nykh/ee445m-robot-team13/Report/Rep6/CAN_Bandwidth_measurement.txt

100ms  O
10ms   O
5ms    O
4ms    X
3ms    X
2ms    X
1ms    X
