nykh/ee445m-robot-team13/Report/Rep6/report6.pdf

# EE445M Lab 6 Report

### Yen-Kai Huang, Siavash Zanganeh Kamali, Chen Cui, Miao Qi, Yan Zhang

### April 8, 2014

## 1 Objective

The goal of this lab is to prepare for the final Robot race. In this lab we will interface various components, including Ping)))) ultrasonic distance sensor, IR distance sensor, and DC motor. A layered communication system using CAN protocol will transmit the information between two microcontrollers. We will design and implement a software communication protocol to transmit the sensor data and other things.
In this lab we will also form a team of 4 or 5, which requires us also to apply communication skills to function as a team.

## 2 Hardware Design

Ping sensor is shown at Figure-1

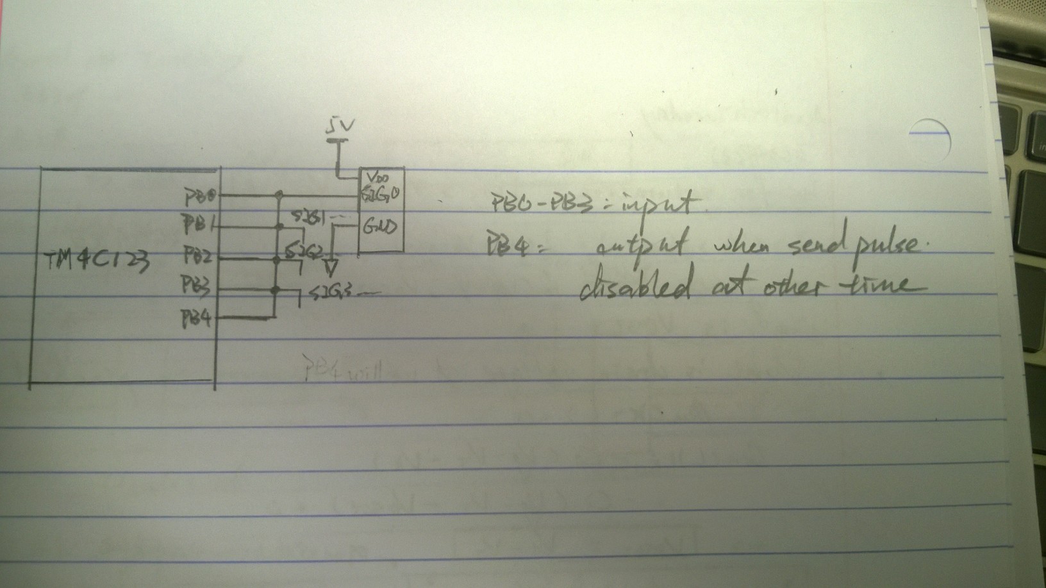
[picture p10: figure]

Figure 1

IR sensor is shown at Figure-2
The DC motor circuit is shown at Figure-3

1


Figure 2

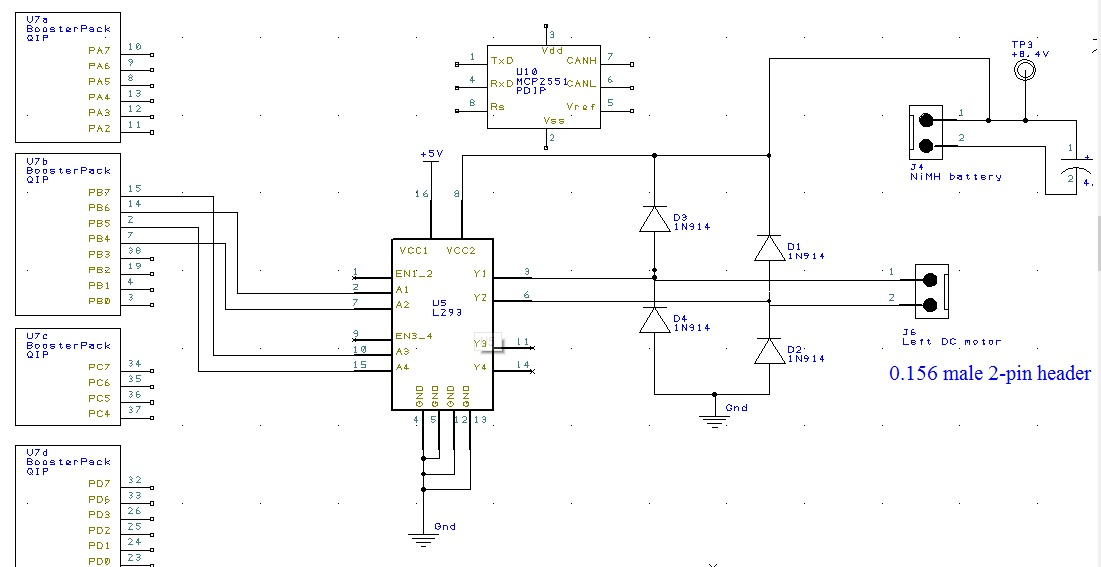
[picture p11: figure]

Figure 3

2

## 3 Software Design

(a) We made small changes to CAN0.c, replacing the spinlock mechanism with actual semaphore.
1 | // can0 .c
2 | // Runs on LM4F120 / TM4C123
3 | // Use CAN0 to communicate on CAN bus PE4 and PE5
4 | //

5
6 | // Jonathan Valvano
7 | // March 22 , 2014

8
9 | /* This example accompanies the books
10 | Embedded Systems : Real - Time Operating Systems for ARM Cortex -M
Microcontrollers , Volume 3 ,
11 ISBN : 978 -1466468863 , Jonathan Valvano , copyright (c) 2013

12
13 Embedded Systems : Real Time Interfacing to ARM Cortex M Microcontrollers , Volume 2
14 ISBN : 978 -1463590154 , Jonathan Valvano , copyright (c) 2013

15
16 | Copyright 2014 by Jonathan W. Valvano , valvano@mail . utexas .edu
17 | You may use , edit , run or distribute this file
18 | as long as the above copyright notice remains
19 | THIS SOFTWARE IS PROVIDED "AS IS ". | NO WARRANTIES , WHETHER EXPRESS ,
IMPLIED
20 | OR STATUTORY , INCLUDING , BUT NOT LIMITED TO , IMPLIED WARRANTIES OF
21 | MERCHANTABILITY AND FITNESS FOR A PARTICULAR PURPOSE APPLY TO THIS
SOFTWARE .
22 VALVANO SHALL NOT , IN ANY CIRCUMSTANCES , BE LIABLE FOR SPECIAL , INCIDENTAL ,
23 | OR CONSEQUENTIAL DAMAGES , FOR ANY REASON WHATSOEVER .
24 | For more information about my classes , my research , and my books , see
25 | http :// users .ece . utexas .edu /~ valvano /
26 | */
27 | // MCP2551 Pin1 TXD | ---- CAN0Tx PE5 (8) O TTL CAN module 0 transmit
28 | // MCP2551 Pin2 Vss | ---- ground
29 | // MCP2551 Pin3 VDD | ---- +5V with 0.1 uF cap to ground
30 | // MCP2551 Pin4 RXD | ---- CAN0Rx PE4 (8) I TTL CAN module 0 receive
31 | // MCP2551 Pin5 VREF ---- open (it will be 2.5 V)
32 | // MCP2551 Pin6 CANL ---- to other CANL on network
33 | // MCP2551 Pin7 CANH ---- to other CANH on network
34 | // MCP2551 Pin8 RS | ---- ground , Slope - Control Input ( maximum slew
rate )
35 // 120 ohm across CANH , CANL on both ends of network

36
37 | # include " hw_can .h"
38 | # include " hw_ints .h"
39 | # include " hw_memmap .h"
40 | # include " hw_types .h"
41 | # include "can.h"
42 | # include " debug .h"
43 | # include " interrupt .h"

44
45 | # include "os.h"
46 | # include " semaphore .h"

3

47
48 | # include " can0 .h"
49 | # include "inc/ tm4c123gh6pm .h"

50

51
52 | # define NULL 0
53 | // reverse these IDs on the other microcontroller

54
55 | // Mailbox linkage from background to foreground
56 | PackageID static RCVID ;
57 | unsigned char static RCVData [4];
58 | int static MailFlag ;

59
60 | // ************************************************************
61 | //
62 | // The CAN controller interrupt handler .
63 | //
64 | // ************************************************************
65 | void CAN0_Handler ( void ) { unsigned char data [4];
66 | unsigned long ulIntStatus , ulIDStatus ;
67 | int i ;
68 | tCANMsgObject xTempMsgObject ;
69 | xTempMsgObject . pucMsgData = data ;
70 | ulIntStatus = CANIntStatus ( CAN0_BASE , CAN_INT_STS_CAUSE ) ; // cause ?
71 | if( ulIntStatus & CAN_INT_INTID_STATUS ) { | // receive ?
72 | ulIDStatus = CANStatusGet ( CAN0_BASE , CAN_STS_NEWDAT ) ;
73 | for( i = 0; i < 32; i ++) { | // test every bit of the mask
74 | if( (0 x1 << i ) & ulIDStatus ) { | // if active , get data
75 | CANMessageGet ( CAN0_BASE , ( i +1) , & xTempMsgObject , true ) ;
76 | // if( xTempMsgObject . ulMsgID == RCV_ID ){
77 | RCVID = ( PackageID ) xTempMsgObject . ulMsgID ;
78 | RCVData [0] = data [0];
79 | RCVData [1] = data [1];
80 | RCVData [2] = data [2];
81 | RCVData [3] = data [3];
82 | // MailFlag = true ; | // new mail
83 | OS_bSignal (& Sema4CAN ) ;
84 | //}
85 | }
86 | }
87 | }
88 | CANIntClear ( CAN0_BASE , ulIntStatus ) ; | // acknowledge
89 | }

90
91 | // Set up a message object . | Can be a TX object or an RX object .
92 | void static CAN0_Setup_Message_Object ( unsigned long MessageID , \
93 | unsigned long MessageFlags , \
94 | unsigned long MessageLength , \
95 | unsigned char * MessageData , \
96 | unsigned long ObjectID , \
97 | tMsgObjType eMsgType ) {
98 | tCANMsgObject xTempObject ;
99 | xTempObject . ulMsgID = MessageID ; | // 11 or 29 bit ID
100 | xTempObject . ulMsgLen = MessageLength ;
101 | xTempObject . pucMsgData = MessageData ;
102 | xTempObject . ulFlags = MessageFlags ;

4

103 | CANMessageSet ( CAN0_BASE , ObjectID , & xTempObject , eMsgType ) ;
104 | }
105 | // Initialize CAN port
106 | void CAN0_Open ( void ) { unsigned long volatile delay ;

107
108 | MailFlag = false ;
109 | OS_InitSemaphore (& Sema4CAN , 0) ;

110
111 | SYSCTL_RCGCCAN_R |= 0 x00000001 ; | // CAN0 enable bit 0
112 | SYSCTL_RCGCGPIO_R |= 0 x00000010 ; | // RCGC2 portE bit 4
113 | for( delay =0; delay <100; delay ++) {};
114 | GPIO_PORTE_AFSEL_R |= 0 x30 ; // PORTE AFSEL bits 5 ,4
115 | // PORTE PCTL 88 into fields for pins 5 ,4
116 | GPIO_PORTE_PCTL_R = ( GPIO_PORTE_PCTL_R &0 xFF00FFFF ) |0 x00880000 ;
117 | GPIO_PORTE_DEN_R |= 0 x30 ;
118 | GPIO_PORTE_DIR_R |= 0 x20 ;

119
120 | CANInit ( CAN0_BASE ) ;
121 | CANBitRateSet ( CAN0_BASE , 80000000 , CAN_BITRATE ) ;
122 | CANEnable ( CAN0_BASE ) ;
123 | // make sure to enable STATUS interrupts
124 | CANIntEnable ( CAN0_BASE , CAN_INT_MASTER | CAN_INT_ERROR |
CAN_INT_STATUS ) ;
125 | // Set up filter to receive these IDs
126 | // in this case there is just one type , but you could accept multiple
ID types
127 // CAN0_Setup_Message_Object (RCV_ID , MSG_OBJ_RX_INT_ENABLE , 4 , NULL , RCV_ID , MSG_OBJ_TYPE_RX );
128 CAN0_Setup_Message_Object (( unsigned long ) ( IRSensor0 ) , MSG_OBJ_RX_INT_ENABLE , 4 , NULL , ( unsigned long ) ( IRSensor0 ) , MSG_OBJ_TYPE_RX ) ;
129 CAN0_Setup_Message_Object (( unsigned long ) ( UltraSonic ) , MSG_OBJ_RX_INT_ENABLE , 4 , NULL , ( unsigned long ) ( UltraSonic ) , MSG_OBJ_TYPE_RX ) ;
130 | NVIC_EN1_R = (1 << ( INT_CAN0 - 48) ) ; // IntEnable ( INT_CAN0 );
131 | return ;
132 | }

133
134 | // send 4 bytes of data to other microcontroller
135 | void CAN0_SendData ( PackageID sendID , unsigned char data [4]) {
136 | // in this case there is just one type , but you could accept multiple
ID types
137 CAN0_Setup_Message_Object (( unsigned long ) sendID , NULL , 4 , data , ( unsigned long ) sendID , MSG_OBJ_TYPE_TX ) ;

138 }

139
140 | // Returns true if receive data is available
141 | // | false if no receive data ready
142 | int CAN0_CheckMail ( void ) {
143 | return MailFlag ;
144 | }
145 | // if receive data is ready , gets the data and returns true
146 | // if no receive data is ready , returns false
147 | /* **** Not implemented
148 | int CAN0_GetMailNonBlock ( unsigned char data [4]) {
149 | if( MailFlag ){

5

150 | data [0] = RCVData [0];
151 | data [1] = RCVData [1];
152 | data [2] = RCVData [2];
153 | data [3] = RCVData [3];
154 | MailFlag = false ;
155 | return true ;
156 | }
157 | return false ;
158 | }
159 | */

160
161 | // if receive data is ready , gets the data
162 | // if no receive data is ready , it waits until it is ready
163 | void CAN0_GetMail ( PackageID * receiveID , unsigned char data [4]) {
164 | OS_bWait (& Sema4CAN ) ;
165 | * receiveID = RCVID ;
166 | data [0] = RCVData [0];
167 | data [1] = RCVData [1];
168 | data [2] = RCVData [2];
169 | data [3] = RCVData [3];
170 | }

code/can0.c

We also modified the FIFO macro to internally include semaphores.

1 | // FIFO .h
2 | // Runs on any LM3Sxxx
3 | // Provide functions that initialize a FIFO , put data in , get data out ,
4 | // and return the current size . | The file includes a transmit FIFO
5 | // using index implementation and a receive FIFO using pointer
6 | // implementation . | Other index or pointer implementation FIFOs can be
7 | // created using the macros supplied at the end of the file .
8 | // Daniel Valvano
9 | // June 16 , 2011

10
11 | // April 2 , 2014
12 | // Modified
13 | // - Added semaphore
14 | // Nick Huang

15
16 | /* This example accompanies the book
17 | " Embedded Systems : Real Time Interfacing to the Arm Cortex M3" ,
18 | ISBN : 978 -1463590154 , Jonathan Valvano , copyright (c) 2011
19 | Programs 3.7 , 3.8. , 3.9 and 3.10 in Section 3.7

20
21 | Copyright 2011 by Jonathan W. Valvano , valvano@mail . utexas .edu
22 | You may use , edit , run or distribute this file
23 | as long as the above copyright notice remains
24 | THIS SOFTWARE IS PROVIDED "AS IS ". | NO WARRANTIES , WHETHER EXPRESS ,
IMPLIED
25 | OR STATUTORY , INCLUDING , BUT NOT LIMITED TO , IMPLIED WARRANTIES OF
26 | MERCHANTABILITY AND FITNESS FOR A PARTICULAR PURPOSE APPLY TO THIS
SOFTWARE .
27 VALVANO SHALL NOT , IN ANY CIRCUMSTANCES , BE LIABLE FOR SPECIAL , INCIDENTAL ,
28 OR CONSEQUENTIAL DAMAGES , FOR ANY REASON WHATSOEVER .

6

29 | For more information about my classes , my research , and my books , see
30 | http :// users .ece . utexas .edu /~ valvano /
31 | */

32
33 | // macro to create an index FIFO
34 | # define AddIndexSema4Fifo (NAME ,SIZE ,TYPE , SUCCESS , FAIL ) \
35 | Sema4Type Sema4 ## NAME ; | \
36 | unsigned long volatile NAME ## PutI ; | \
37 | unsigned long volatile NAME ## GetI ; | \
38 | TYPE static NAME ## Fifo [ SIZE ]; | \
39 | void NAME ## Fifo_Init ( void ){ long sr; | \
40 | sr = StartCritical () ; | \
41 | NAME ## PutI = NAME ## GetI = 0; | \
42 | EndCritical ( sr ) ; | \
43 | OS_InitSemaphore (& Sema4 ## NAME , 0); | \
44 | } | \
45 | int NAME ## Fifo_Put ( TYPE data ){ | \
46 | if (( NAME ## PutI - NAME ## GetI ) & ~( SIZE -1) ){ | \
47 | return ( FAIL ) ; | \
48 | } | \
49 | NAME ## Fifo [ NAME ## PutI &( SIZE -1) ] = data ; \
50 | NAME ## PutI ## ++; | \
51 | OS_Signal (& Sema4 ## NAME ); \
52 | return ( SUCCESS ) ; | \
53 | } | \
54 | int NAME ## Fifo_Get ( TYPE * datapt ){ | \
55 | OS_Wait (& Sema4 ## NAME ); \
56 | if( NAME ## PutI == NAME ## GetI ){ \
57 | return ( FAIL ) ; | \
58 | } | \
59 | * datapt = NAME ## Fifo [ NAME ## GetI &( SIZE -1) ]; | \
60 | NAME ## GetI ## ++; | \
61 | return ( SUCCESS ) ; | \
62 | } | \
63 | unsigned short NAME ## Fifo_Size ( void ){ | \
64 | return (( unsigned short ) ( NAME ## PutI - NAME ## GetI )); | \
65 | }

66
67 | # define AddCallBackFunction ( NAME ) \
68 | long NAME ## DataLost ; | \
69 | void NAME ## CallBack ( unsigned short ADCvalue ) { \
70 | if (! NAME ## Fifo_Put ( ADCvalue )){ | \
71 | NAME ## DataLost ++; | \
72 | } | \
73 | }

code/FIFO sema4.h

(b) IR sensor code is basically the same as Lab. 4, except that I decoupled the Filter() functions from the filter buffer. The call-back functions in ADC routine is now responsible for acquiring and storing the data.

1 // IR_sensor .h

2
3 | # ifndef __IR_SENSOR_H__
4 | # define __IR_SENSOR_H__

7

5
6 # define LAB_DEMO 6

7
8 | void IR_Init ( void ) ;
9 | void IR_getValues ( unsigned short * buffer ) ;

10
11 | # endif // __IR_SENSOR_H__
| | | code/ir sensor.h
1 | // IR_sensor .c

2
3 # include " ir_sensor .h"

4
5 | # include "OS.h"
6 | # include " FIFO_sema4 .h"
7 | # include "adc.h"

8
9 # define SAMPLING_RATE 2000

10
11 | /* ********************* Data Structure ****************** */
12 | # define FIFOSIZE | 64 | // size of the FIFOs ( must be power of 2)
13 | # define FIFOSUCCESS 1 | // return value on success
14 | # define FIFOFAIL | 0 | // return value on failure
15 | | | // create index implementation FIFO (see
| FIFO .h)
16 | long StartCritical ( void ) ; | // previous I bit , disable interrupts
17 | void EndCritical ( long sr ) ; | // restore I bit to previous value

18
19 | AddIndexSema4Fifo ( IR1 , FIFOSIZE , unsigned short , FIFOSUCCESS , FIFOFAIL )
20 | AddCallBackFunction ( IR1 )

21
22 | #if LAB_DEMO == 7
23 | AddIndexSema4Fifo ( IR2 , FIFOSIZE , unsigned short , FIFOSUCCESS , FIFOFAIL )
24 | AddCallBackFunction ( IR2 )
25 | AddIndexSema4Fifo ( IR3 , FIFOSIZE , unsigned short , FIFOSUCCESS , FIFOFAIL )
26 | AddCallBackFunction ( IR3 )
27 | AddIndexSema4Fifo ( IR4 , FIFOSIZE , unsigned short , FIFOSUCCESS , FIFOFAIL )
28 | AddCallBackFunction ( IR4 )
29 | # endif

30
31 | /* ********************** Filter *************************** */
32 | # define FILTER_LENGTH 51
33 | const long ScaleFactor = 16384;
34 | const long H [51]={ -11 ,10 ,9 , -5 ,1 ,0 , -19 ,6 ,48 , -12 , -92 ,
35 | 17 ,155 , -20 , -243 ,22 ,370 , -24 , -559 ,24 ,881 , -24 , -1584 ,24 ,4932 ,
36 | 8578 ,4932 ,24 , -1584 , -24 ,881 ,24 , -559 , -24 ,370 ,22 , -243 , -20 ,155 ,
37 | 17 , -92 , -12 ,48 ,6 , -19 ,0 ,1 , -5 ,9 ,10 , -11};

38
39 | typedef struct {
40 | // this MACQ needs twice the size of FILTER_LENGTH
41 | long x [2* FILTER_LENGTH ];
42 | unsigned char index ;
43 | } FilterType ;

44
45 | static unsigned short IRsensor1 ;
| | | 8

46
47 static FilterType filter1 = {{0} , FILTER_LENGTH -1};

48
49 | // Filter
50 | // Digital FIR filter , assuming fs =1 Hz
51 | // Coefficients generated with FIRdesign64 .xls
52 | // y[i]= (h [0]* x[i]+h [1]* x[i -1]+ | +h [63]* x[i -63]) /256;
53 | static unsigned short Filter ( FilterType *f , unsigned short data ) {
54 | long y = 0;
55 | unsigned char i ;

56
57 | if (++ f - > index == 2* FILTER_LENGTH ) f - > index = FILTER_LENGTH ;
58 | f - > x [f - > index ] = f - > x [f - > index - FILTER_LENGTH ] = data ;

59
60 | // Assuming there is no overflow
61 | for( i = 0; i < FILTER_LENGTH ; ++ i ) {
62 | y += H [ i ]* f - > x [f - > index - i ];
63 | }
64 | y /= ScaleFactor ;

65
66 | return y ;
67 | }

68
69 /* *************************************************** */

70
71 | // Consumer
72 | // Foreground thread that takes in data from FIFO , apply filter , and
record data
73 // If trigger Capture is set , it will perform a 64 - point FFT on the recorded data
74 | // and store result in fft_output []
75 | // Block when the FIFO is empty
76 | # define NOW_USING | 1
77 | # define STOP_USING | 0
78 | # define NOT_USING | -1
79 | char Filter_Use = NOT_USING ;

80
81 | static void Consumer ( void ) {
82 | ADC_Collect (0 , SAMPLING_RATE , IR1CallBack , 64) ;

83
84 | while (1) {
85 | // Get data , will block if FIFO is empty
86 | unsigned short data ;
87 | IR1Fifo_Get (& data ) ;

88
89 | // Choosing whether to apply the filter
90 | IRsensor1 = Filter (& filter1 , data ) ;
91 | }
92 | }

93
94 | void IR_Init ( void ) {
95 | OS_InitSemaphore (& Sema4DataAvailable , 0) ;

96
97 IR1Fifo_Init () ;

98
99 OS_AddThread (& Consumer , 256 , 3) ;

9

100 }

101
102 | void IR_getValues ( unsigned short * buffer ) {
103 | buffer [0] = IRsensor1 ;
104 | #if LAB_DEMO == 7
105 | buffer [1] = IRsensor2 ;
106 | buffer [2] = IRsensor3 ;
107 | buffer [3] = IRsensor4 ;
108 | # endif
109 | }
| | code/ir sensor.c

For the Ping))) interfacing, we used one pin to output the 5 µs pulse, and one pin for each sensor set to trigger an interrupt at both edges. The handler will calculate the difference of time between the two edges and thus determine the distance measurement.

1 | // Ping .h
2 | // Runs on LM4C123
3 | // Initialize Ping interface , then generate 5us pulse about 10 times
| per second
4 | // capture input pulse and record pulse width
5 | // Miao Qi
6 | // October 27 , 2012

7
8 | // initialize PB4 -0
9 | // PB4 set as output to send 5us pulse to all four Ping ))) sensors at
| same time
10 | // PB3 -0 set as input to capture input from sensors
11 | void Ping_Init ( void ) ;

12
13 | void Ping_getData ( unsigned long * data ) ;
| | code/ping.h
1 | // Ping .c
2 | // Runs on LM4C123
3 | // Initialize Ping interface , then generate 5us pulse about 10 times
| per second
4 | // capture input pulse and record pulse width
5 | // Miao Qi
6 | // October 27 , 2012

7
8 | # include "inc/ tm4c123gh6pm .h"
9 | # include "OS.h"

10
11 | # define PB4 | (*(( volatile unsigned long *)0 x40005040 ))
12 | # define PB3_0 | (*(( volatile unsigned long *)0 x4000503C ))
13 | # define Temperature | 20
14 | # define NVIC_EN0_INT1 | 2

15
16 # define TIME_1MS 80000

17
18 | unsigned long Ping_Lasttime [4];
19 | unsigned long Ping_Finishtime [4];
20 | unsigned char Ping_Update ;
21 | unsigned long Ping_Distance_Result [4];

10

22 | unsigned long Ping_Distance_Filter [4][4];
23 | // unsigned long Ping_Distance_cal [10];
24 | unsigned long Ping_Index [4];
25 | unsigned long Ping_laststatus ;

26
27 void Ping_pulse ( void ) ;

28
29 | // initialize PB4 -0
30 | // PB4 set as output to send 5us pulse to all four Ping ))) sensors at
same time
31 | // PB3 -0 set as input to capture input from sensors
32 | void Ping_Init ( void ) {
33 | // (a) activate clock for port F
34 | SYSCTL_RCGC2_R |= SYSCTL_RCGC2_GPIOB ;
35 | Ping_laststatus = 0; | // (b) initialize status
36 | GPIO_PORTB_DIR_R &= ~0 x0F ; | // (c) make PB3 -0 in
37 | GPIO_PORTB_DIR_R |= | 0 x10 ; | // (c) make PB4 out
38 | GPIO_PORTB_AFSEL_R &= ~0 x1F ; | // | disable alt funct on PB4 -0
39 | GPIO_PORTB_DEN_R |= 0 x1F ; | // | enable digital I/O on PB4 -0
40 | GPIO_PORTB_PCTL_R &= ~0 x000FFFFF ; // configure PB4 -0 as GPIO
41 | GPIO_PORTB_AMSEL_R = 0; | // | disable analog functionality on
PB
42 | GPIO_PORTB_PDR_R |= 0 x1F ; | // | enable pull - down on PF4 -0
43 | GPIO_PORTB_IS_R &= ~0 x0F ; | // (d) PB3 -0 is edge - sensitive
44 | GPIO_PORTB_IBE_R |= 0 x0F ; | // | PB3 -0 is both edges
45 | GPIO_PORTB_ICR_R = | 0 x0F ; | // (e) clear flag3 -0
46 | GPIO_PORTB_IM_R |= 0 x0F ; | // (f) arm interrupt on PB3 -0
47 | NVIC_PRI0_R = ( NVIC_PRI0_R &0 xFFFF00FF ) |0 x00004000 ; // (g) priority 2
48 | NVIC_EN0_R |= NVIC_EN0_INT1 ; | // (h) enable interrupt 1 in NVIC
49 | OS_AddPeriodicThread (& Ping_pulse , 100* TIME_1MS , 3) ;
50 | }

51
52 | extern unsigned char SendPulse ;
53 | extern unsigned long PulseCount ;
54 | // Send pulse to four Ping ))) sensors
55 | // happens periodically by using timer
56 | // foreground thread
57 | // Fs: about 10 Hz
58 | // no input and no output

59
60 | void Ping_pulse ( void ) {
61 | unsigned char delay_count ;
62 | GPIO_PORTB_DEN_R |= 0 x10 ;
63 | GPIO_PORTB_DEN_R &= ~0 x0F ;
64 | PB4 = 0 x10 ;
65 | // blind - wait
66 | for( delay_count =0; delay_count <60; ) { delay_count ++;}
67 | PB4 = 0 x00 ;
68 | GPIO_PORTB_DEN_R &= ~0 x10 ;
69 | GPIO_PORTB_DEN_R |= | 0 x0F ;
70 | }

71
72 | unsigned long median ( unsigned long * data_record ) {
73 | unsigned long buffer [4];
74 | // compare the oldest two data
75 | if ((* data_record ) <*( data_record +1) )

11

76 | { buffer [0]=* data_record ; buffer [1]=*( data_record +1) ;}
77 | else
78 | { buffer [1]=* data_record ; buffer [0]=*( data_record +1) ;}
79 | // compare the third data
80 | if( buffer [0] <*( data_record +2) ) {
81 | if( buffer [1] <*( data_record +2) ) { buffer [2]=*( data_record +2) ;}
82 | else { buffer [2]= buffer [1]; buffer [1]=*( data_record +2) ;}
83 | }
84 | else { buffer [2]= buffer [1]; buffer [1]= buffer [0]; buffer [0]=*( data_record
+2) ;}
85 | // compare the forth data
86 | // ingore the forth data when it is the laragest
87 | if( buffer [2] >*( data_record +3) ) {
88 | | // ingore the forth data when it is the smallest
89 | | if( buffer [0] >*( data_record +3) ) { buffer [2]= buffer [1]; buffer [1]= buffer
[0];}}
90 | | else { buffer [2]=*( data_record +3) ;}
91 | return ( buffer [1]+ buffer [2]) > >1;
92 | }

93

94

95
96 | //d=c* tIN /2
97 | //d = c * tIN * 12.5 ns /2 * (um/us)
98 | //d = c * tIN * (1 us /40) /(2*2) * (um/us)
99 | //d = c * tIN / (40*2*2) * um
100 | // ignore underflow
101 | // +0.5: round
102 | // return distance = (( tin /40) *(331+0.6* Temperature +0.5) )/4;
103 | // compute and update distance array for four sensors
104 | // called when PORTB3 -0 capture a value change
105 | // output resolution um
106 | void Distance ( void ) {
107 | unsigned char bits_I = 0;
108 | unsigned long tin ;
109 | for ( bits_I =0; bits_I <4; bits_I ++)
110 | if( Ping_Update &(1 < < bits_I ) ) {
111 | | tin = OS_TimeDifference ( Ping_Finishtime [ bits_I ] , Ping_Lasttime [
bits_I ]) ;
112 | | tin = (( tin /40) *(331+0.6* Temperature +0.5) ) /4;
113 | | Ping_Distance_Filter [ bits_I ][ Ping_Index [ bits_I ]&0 x3 ] = tin ;
114 | | Ping_Index [ bits_I ]++;
115 | | Ping_Distance_Result [ bits_I ] = median (& Ping_Distance_Filter [ bits_I
][0]) ;
116 | // | Ping_Distance_Result [ bits_I ] = tin //80000;
117 | | Ping_Update &= ~(1 < < bits_I ) ;
118 | }
119 | }

120

121
122 | // put inside PORTB_handler
123 | // input system time , resolution : 12.5 ns
124 | // no output
125 | void GPIOPortB_Handler ( void ) {
126 | // void Ping_measure ( void ){
127 | unsigned char bits_I = 0;
| | 12

128 | unsigned long Ping_status ;
129 | Ping_status = PB3_0 ;
130 | // check rising edge and record time
131 | for ( bits_I =0; bits_I <4; bits_I ++) {
132 | Ping_Lasttime [ bits_I ] = (( Ping_status &(1 < < bits_I ) ) && !(
| Ping_laststatus &(1 < < bits_I ) ) ) ? OS_Time () : Ping_Lasttime [ bits_I ];
133 | GPIO_PORTB_ICR_R = 1 < < bits_I ;
134 | }
135 | // check falling edge and compute distance
136 | for ( bits_I =0; bits_I <4; bits_I ++) {
137 | Ping_Finishtime [ bits_I ] = (!( Ping_status &(1 < < bits_I ) ) && (
| Ping_laststatus &(1 < < bits_I ) ) ) ? OS_Time () : Ping_Finishtime [ bits_I ];
138 | GPIO_PORTB_ICR_R = 1 < < bits_I ;
139 | Ping_Update |= 1 < < bits_I ;
140 | }
141 | Ping_laststatus = Ping_status ;
142 | }

143
144 | void Ping_getData ( unsigned long * data ) {
145 | int i ;
146 | Distance () ;
147 | for ( i =0; i <4; i ++) {
148 | data [ i ] = Ping_Distance_Result [ i ];
149 | }
150 | }
| code/ping.c
(c) The code that sets up the distributed data acquisition system comes in two sides. On the transmitter side, the main initializes the sensors and network, and sends data periodically at about 10 Hz.
1 | void NetworkSend ( void ) {
2 | unsigned short IRvalues [4];
3 | unsigned long sonarValues [4];
4 | unsigned char CanData [4];

5
6 | IR_getValues ( IRvalues ) ;
7 | (( unsigned short *) CanData ) [0] = IRvalues [0];
8 | CAN0_SendData ( IRSensor0 , CanData ) ;

9
10 | Ping_getData ( sonarValues ) ;
11 | (( unsigned long *) CanData ) [0] = sonarValues [0];
12 | CAN0_SendData ( UltraSonic , CanData ) ;
13 | }

14
15 | int main ( void ) {
16 | PLL_Init () ;
17 | OS_Init () ;

18
19 | // Initialize sensors
20 | IR_Init () ;
21 | Ping_Init () ;

22
23 | // Initialize network
24 | CAN0_Open () ;

25

| 13

NumCreated += OS_AddPeriodicThread (& NetworkSend , 100* TIME_1MS , 3) ;

OS_Launch ( TIMESLICE ) ;

}

code/main TX.c

On the receiver side, the main initializes the display and network, then add a thread that waits for the packet from the network. Once it receives a packet, it checks the packet ID to determine the type of data and then publish it to the display.

void NetworkReceive ( void ) {
PackageID receiveID ;
unsigned char canData [4];

// Initialize network
CAN0_Open () ;

while (1) {
CAN0_GetMail (& receiveID , canData ) ;
switch ( receiveID ) {
case IRSensor0 :
ST7735_Message (0 ,0 ,"IR0 : ", (( unsigned short *) canData ) [0]) ; dataReceived ++;
break ;
case UltraSonic :
ST7735_Message (0 ,1 ," ULS0 : ", (( unsigned long *) canData ) [0]) ; break ;
default :
break ;

}

}

}

int main ( void ) {
PLL_Init () ;
OS_Init () ;

// Initialize Display
ST7735_InitR ( INITR_REDTAB ) ; ST7735_SetRotation (1) ;
ST7735_FillScreen (0) ;

NumCreated += OS_AddThread (& NetworkReceive ,128 ,1) ;

OS_Launch ( TIMESLICE ) ;

}

code/main RX.c

This is a very simplistic example, however, it contains the full range of function for a distributed Data Acquisition System.

## 4 Measurement

(a) Ping))) Calibration Ping measurements in Table-1

14

Ping measurements
Truth dT(cm) | measured dM(cm) | standard deviation | span
10 20 30 50 80 | 10.1538 20.7653 31.4354 52.7532 83.1323 | 10.2742 20.9498 31.2317 52.8654 82.1398 | 10.129 20.4286 31.2342 52.2543 83.2538 | 10.2398 20.5348 31.5463 52.7397 84.0132 | 9.9102 20.8695 31.8467 52.9485 83.8764 | 10.1231 21.0135 31.6756 53.0123 83.1233 | 10.2314 20.8493 31.3765 52.9475 82.4956 | 9.9324 20.9756 31.0475 53.2397 83.2835 | 0.136715993 0.212323325 0.260240679 0.286319955 0.626714781 | 0.364 0.5849 0.7992 0.9854 1.8734

Table 1: Ping measurements

IR sensor measurements
Truth dT(c0) | ADC average | ADC Std. Dev. | ADC span | Voltage average(V) | Voltage Std. Dev.(V) | Voltage span (V)
10 15 20 25 30 35 40 45 50 | 2822 1979 1570 1282 1114 941 848 748 675 | 5 4 5 6 5 2 7 6 5 | 19 15 19 25 27 8 23 24 18 | 2.067 1.450 1.150 0.939 0.816 0.689 0.621 0.548 0.494 | 0.004 0.003 0.003 0.005 0.004 0.001 0.005 0.004 0.003 | 0.014 0.011 0.014 0.018 0.020 0.006 0.017 0.018 0.013

Table 2: IR measurements

(b) IR sensor Calibration IR sensor measurements in Table-2
(c) IR sensor noise spectrum We held a piece of paper constant from the IR sensor and recorded this noise spectrum. Because the measured object is nearly static, everything except the DC component should be considered noise. The noise therefore includes a noise floor that spans all frequencies. The major source of the noise is the thermal noise that includes all frequency and with amplitude of 1
f

. The
other source of noise is electrostatics property of the sensor itself, which shows a visible small squarewave in the time domain. This squarewave translates to a noise of all frequency in the frequency domain.

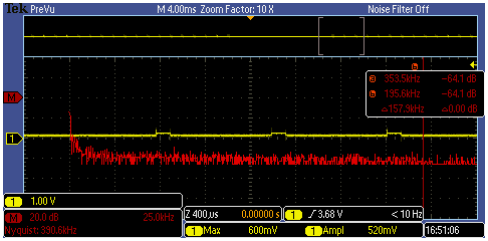
[picture p12: figure]

Figure 4: Frequency spectrum of noise

(d) Motor DC Motor measurements in Table-3
(e) CAN scope picture Below is a CAN packet measured at the CANH bus (yellow) and the microcontroller output (blue). It can be observed that the CANH signal is a inverted version of the microcontroller output, however the microcontroller output is changing between 0 and 3.3 V , and the CANH signal is changing between about 2.5 and 3.8 V . Also, the length of a typical packet is 161.7 µs
(f) CAN Network bandwidth We set the CAN network bit rate at 1M bit and decrease the sampling period of IR sensor. The result is shown in Table-4.
Therefore we deduct the maximum sampling rate the system can handle is 1
5 ms×4 bytes = 800 bytes/sec. Considering the packet length measured in Figure-5, CAN network itself should not be the limiting fac-

15

DC Motor measurements
Condition | Voltage across motor | Current
no-load with rubber wheel wheel & on carpet | 4.41v 4.42v 4.42v | 32mA 34mA 100mA

Table 3: DC motor measurements

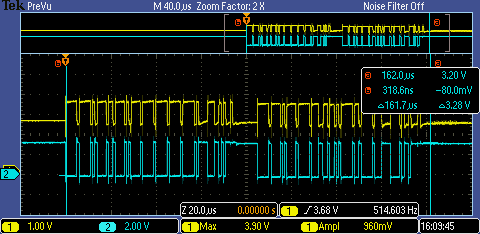
[picture p13: figure]

Figure 5: Scope trace of a typical CAN packet

CAN Bandwidth
Sampling Rate | Data Lost
100 ms 10 ms 5 ms 4 ms 3 ms 2 ms 1 ms | No No No Yes Yes Yes Yes

Table 4: Bandwith measurement

16 tor. The limiting factor is probably the execution speed of the data acquisition thread on the receiver side, which needs to run a 51-point filter code for each IR sensor data.

## 5 Analysis

(1) What is one advantage of the Ping))) sensor over the GP2Y0A21YK sensor? Ping))) outputs a PWM signal which duty cycles changes linearly with respect to the distance, so it’s easier to convert the raw data to distance.
(2) What is one advantage of the GP2Y0A21YK sensor over the Ping))) sensor GP2Y0A21YK measures the distance by an analog voltage. It is easier to convert voltage to digital data using ADC compared to measure time in Ping.
(3) Describe the noise of the GP2Y0A21YK when measured with a spectrum analyzer. The noise of the sensor is periodic square waves. An square wave contains all different frequencies, with Maximum amplitude at the frequency of the square wave. You can see that the spectrum detects many different frequencies.
(4) Why did you choose the digital filters for your sensors?
What is the time constant for this filter? I.e., if there is a step change in input, how long until your output changes to at least 1/e of the final value?
Since the transition bandwidth of the analog filter is too large for a 2-pole low-pass filter, therefore we use the digital filter to filter out the noise.
An analog filter with higher poles is more expensive.
Since we’re using a 51 point FIR filter, and 1/e = 0.36, we need to sample about 17 points to get enough data to represent 0.36 of the input.
Therefore, time constant = 17
fc

= 8.5 ms

(5) Present an alternative design for your H-bridge and describe how your H-bridge is better or worse?
Alternate design is shown as Figure-6
Using our H-bridge is a trade-off. It is better in the simplicity of circuit design so to minimize risk of damaging circuit. Also it saves space. The alternate H-bridge is more sophisticated. This design gets a faster response time of the signal. However it’s easier to cause problem and needs more components.
(6) Give the single-most important factor in determining the maximum bandwidth on this distributed system. Give the second-most important factor. Justify your answers.
Since the system bandwidth was much less than the most possible theoretical bandwidth according to bit rate, the most important factor is the amount of time needed to prepare a package to be sent in the CAN driver, and the amount of time to receive and interpret an incoming package.
The second-most important factor is the bit-rate that determines the amount of time it takes for a single package to be transmitted over the bus.

17

Alternative H-bridge circuit at Figure-6

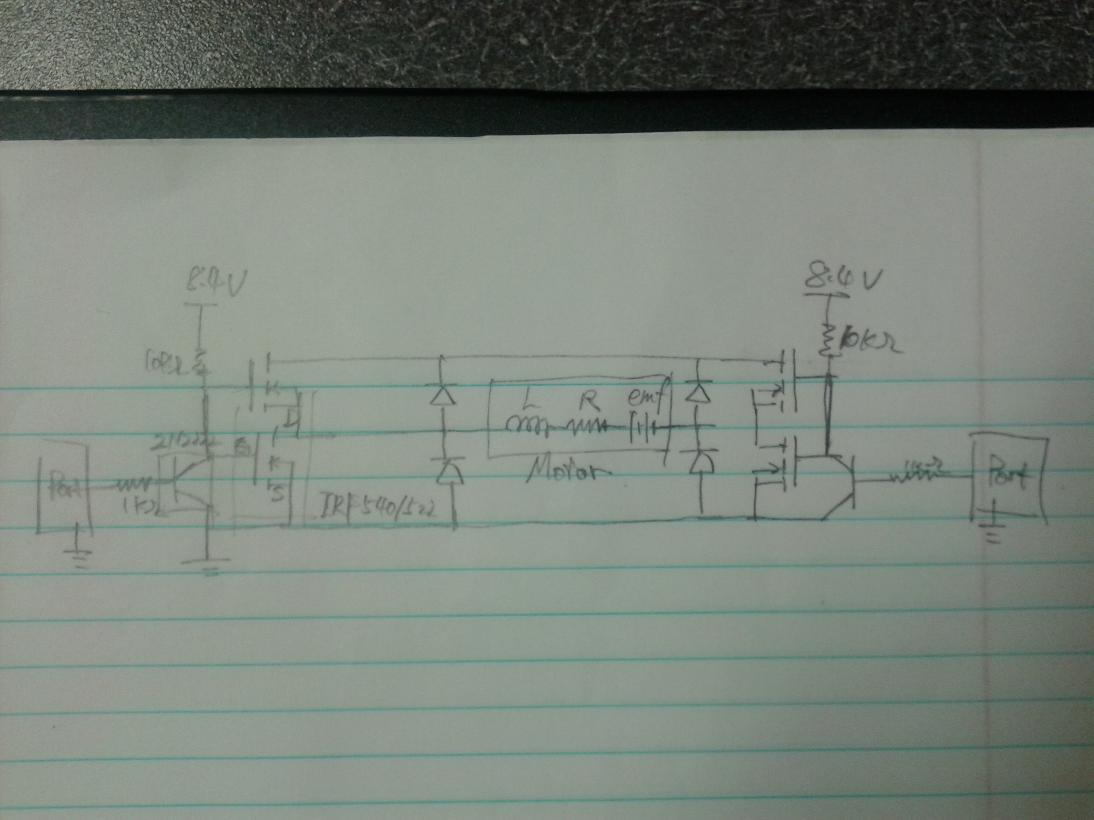
[picture p14: figure]

Figure 6

## 6 Post-Mortem Team Evaluation

Here we evaluate the Strengths and Weaknesses by teammate.

### 6.1 Chen Cui

Chen not obvious in this lab; write code slowly

YKH Knowledge in C and embedded system; unknown

MQ perfectionist and experience in C; unknown

Siavash knowledge and experience; unknown

ZY knowledge in mechanical and hard-working; unknown

### 6.2 Yen-Kai Huang

Chen Hardworking and experienced in motor interfacing; None

YKH Experience in Embedded system and LATEX; Not very concentrated

MQ Hardworking and easy to work with; Code style is not professional

Siavash Excellent embedded programmer; He is often busy with the senior design project

ZY Very experienced in mechanical engineering and ability of hands-on work ; Lack of embedded experience

18

### 6.3 Miao Qi

Chen code is easy readable and in good style, good lab partner; None

YKH His code is stylish and easy-readable, strong leadership; None

MQ easy to communicate; code is not very portable

Siavash Extremely strong coding skill, good organization skill; None

ZY hard working, like to explore deeply; None

### 6.4 Siavash Zangeneh Kamali

Chen Hardware interface, embedded systems; Not clear and concise in coding style

YKH Precise and clear coding style, good at programming, experienced in embedded systems ; Too much perfectionist

MQ on-time, hard working; Not clear and concise in coding style

Siavash good at programming, experienced in embedded systems ; Doesn’t do things until the deadline is written

ZY Mechanical engineering stuff, hard working; Not clear and concise in coding style

### 6.5 Yan Zhang

Chen 1. expert in the lab 2. working hard ; (It’s impossible for me to see you guys’ weakness...)

YKH 1. expert in the lab 2. working hard ; (It’s impossible for me to see you guys’ weakness...)

MQ 1. expert in the lab 2. working hard ; (It’s impossible for me to see you guys’ weakness...)

Siavash 1. expert in the lab 2. working hard ; (It’s impossible for me to see you guys’ weakness...)

ZY 1. never give up trying 2. working hard ; 1. little background in EE

### Failure and Success in Communication

We started out early with logistics and use new internet technology to improve our communication, for example code repository and smartphone apps. The only thing preventing us from better communicating is the language barrier because we all speak English as a second language, but despite this we are able to work beyond the nationality and function well. Our success in communication is that we have been able to meet punctually and we have a strong leadership and clear job assignment that makes everybody engaged and working.

19
