nykh/ee445m-robot-team13/Report/Rep6/IR_sensor_coefficient.xlsx

order | coefficient a | coefficient fixed point
5 | 200.3775041 | 820746.2566
4 | -2.265766565 | -9280.57985
3 | 0.01163953288 | 47.67552667
2 | -2.99194195e-05 | -0.1225499423
1 | 3.74087e-08 | 0.0001532260352
0 | -1.81e-11 | -7.41376e-08
 | multiplier
 | 4096
