nykh/ee445m-robot-team13/Report/Rep6/IR_sensor_conversion.png

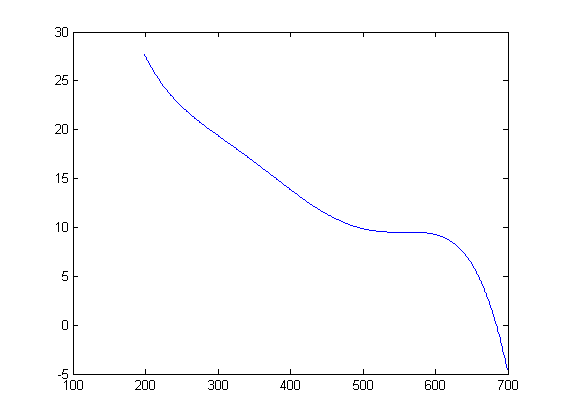
Report/Rep6/IR_sensor_conversion.png
