nykh/ee445m-robot-team13/Report/Rep6/scope/ir_fft.PNG

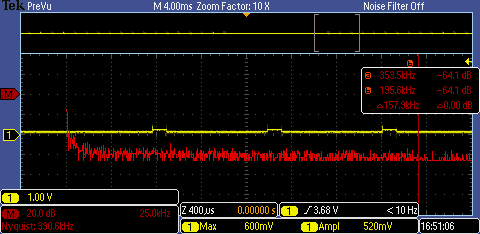
Report/Rep6/scope/ir_fft.PNG
