nykh/ee445m-robot-team13/Lab6BOM.xls

Sheet: Parts
Bill of Materials |  |  | 2013-01-15 | "not free" means you have to buy it |  | "free sample" means you have to order it
EE445L Spring 2013 |  |  | EE445L pays for the PCB | "Cabinet means in one of the six black cabinets in Bards's office (bring a print out of your SCH")
 |  |  |  | "Valvano" means ask Valvano, quantity and style will vary (bring a print out of your SCH circuit)
Qty Note | REF DES Note (http://projects.ece.utexas.edu/valvano/wiki/doku.php?id=pcbartist:schematics) |  |  | "Box means in box in your Bard's office (bring a print out of your SCH circuit)
Quantity | REF DES | Type | Description | Manufacturer | Mfg. P/N | Distributor | P/N | Unit cost | Cost | PCB Artist | Where to get it? | Inventory
0 |  | ASM | 32-ohm speaker |  |  | AllElectronics | SK-230 | $0.50 | $0.00 | Speaker | Cabinet
0 |  | ASM | 5-pin 0.100" w/retention + 3" cable asm |  |  | AllElectronics | CON-55 | $1.35 | $0.00 | Jumper5 | not free
0 |  | ASM | 9V battery snap, T-type |  |  | AllElectronics | BST-61 | $0.50 | $0.00 | Jumper2 | Box
0 |  | ASM | Black case, 5.512"x 2.165"x 1.102" | Hammond | 1593YBK | Mouser | 546-1593YBK | $3.83 | $0.00 | Mammond1593Y | Box | http://www.hammondmfg.com/pdf/1593Y.pdf
0 |  | ASM | Black case, 7.5" by 4.3" by 2.2" | Hammond | 1591ESBK | Mouser | 546-1591ES-BK | $5.18 | $0.00 | to do | Box | http://www.hammondmfg.com/pdf/1591E.pdf
0 |  | ASM | Black case, 7"x 5-13/16"x 2" |  |  | BGMicro | CAS1007 | $1.00 | $0.00 | CAS1007 | none
0 |  | ASM | Electret microphone | Panasonic |  | AllElectronics | MIKE-74 | $0.50 | $0.00 | electret | Cabinet
0 |  | ASM | Stepper Motor |  |  |  |  | $5.00 | $0.00 | StepperMotor | not free
0 |  | CAP | Ceramic, X7R, 20%, 1 uF |  |  | Jameco | 81509 | $0.35 | $0.00 | Ceramic0.2 | Cabinet
0 |  | CAP | Ceramic, Z5U, -20/+80%, 0.47 uF | Kemet | C320C474M5U5TA | Digikey | 399-4309-ND | $0.40 | $0.00 | Ceramic | Cabinet
0 |  | CAP | Ceramic mono, Z5U, -20/+80%, 0.1 uF |  |  | Jameco | 25523 | $0.04 | $0.00 | Ceramic | Cabinet
0 |  | CAP | Ceramic, Z5U, -20/+80%, 0.033 uF |  |  | Digikey | 399-4298-ND | $0.40 | $0.00 | Ceramic | Cabinet
0 |  | CAP | Ceramic, Z5U, -20/+80%, 0.027uF |  |  |  |  | $0.40 | $0.00 | Ceramic | Cabinet
12 |  | CAP | Ceramic, Z5U, -20/+80%, 0.01 uF |  |  | Digikey | 399-4188-ND | $0.40 | $4.80 | Ceramic | Cabinet
0 |  | CAP | Ceramic, Z5U, -20/+80%, 0.0047 uF |  |  |  |  | $0.40 | $0.00 | Ceramic | Cabinet
0 |  | CAP | Ceramic Z5U, -20/+80%, 470 pF |  |  |  |  | $0.03 | $0.00 | Ceramic | Cabinet
0 |  | CAP | Ceramic Z5U, -20/+80%, 100 pF |  |  |  |  | $0.03 | $0.00 | Ceramic | Cabinet
0 |  | CAP | Ceramic Z5U, -20/+80%, 22 pF |  |  | Jameco | 15405 | $0.03 | $0.00 | Ceramic | Cabinet
0 |  | CAP | Ceramic C0G, 10%, 18 pF | AVX Corporation | SR151A180JAR | Digikey | 478-5210-ND | $0.17 | $0.00 | Ceramic | Cabinet
0 |  | CAP-Tant | Tantalum, 16V, 10% 4.7 uF |  |  | Jameco | 94035 | $0.22 | $0.00 | tantalum | Cabinet
0 |  | CAP-Tant | Tantalum, 20V, 10%, 1 uF |  |  | Digikey | 478-1833-ND | $0.32 | $0.00 | tantalum | Cabinet
0 |  | CAP-Tant | Tantalum, 10UF 20V 10% |  |  | Digikey | 478-1840-ND | $0.56 | $0.00 | tantalum | Cabinet
0 |  | CAP-Tant | Tantalum, 35V, 10%, 0.47 uF |  |  | Jameco | 33531 | $0.19 | $0.00 | tantalum | Cabinet
0 |  | CON | 2-pin for TechArts power plug |  |  | AllElectronics | CON-242 | $0.70 | $0.00 | PowerJumper | Cabinet
0 |  | CON | 2 to 40 pin 0.1 in header (price per pin) |  |  | AllElectronics | SHS-40 | $0.02 | $0.00 | Jumper2 | Cabinet
0 |  | CON | 2-pin header |  |  | AllElectronics | SBH-2 | $0.10 | $0.00 | Jumper2 | Cabinet
0 |  | CON | 2-pin jumper |  |  | AllElectronics | SBC-2 | $0.27 | $0.00 | goes with SBH-2 | Cabinet
0 |  | CON | 2-pin jumper |  |  | AllElectronics | SJ-1 | $0.10 | $0.00 | goes with Jumper2 | Cabinet
0 |  | CON | Test point, black | Keystone Electronics | 5001 | Digikey | 5001K-ND | $0.29 | $0.00 | testpoint | Cabinet
0 |  | CON | Test point, orange | Keystone Electronics | 5003 | Digikey | 5003K-ND | $0.29 | $0.00 | testpoint | Cabinet
0 |  | CON | Test point, yellow | Keystone Electronics | 5004 | Digikey | 5004K-ND | $0.29 | $0.00 | testpoint | Cabinet
0 |  | CON | Test point, white | Keystone Electronics | 5002 | Digikey | 5002K-ND | $0.29 | $0.00 | testpoint | Cabinet
0 |  | CON | Test point, red | Keystone Electronics | 5000 | Digikey | 5000K-ND | $0.29 | $0.00 | testpoint | Cabinet
0 |  | CON | MSP430 debugging connector | SamTec | SLM-104-01-G-S | SamTec |  |  | $0.00 | SLM-4 | Cabinet
0 |  | CON | 14-pin LCD connector | SamTec | BCS-114-L-S-TE | SamTec |  |  | $0.00 | HD44780 | Cabinet
0 |  | CON | 16-pin LCD connector | SamTec | BCS-116-L-S-TE | SamTec |  |  | $0.00 | HD44780_16pin | Cabinet
0 |  | CON | 20-pin LCD connector | SamTec | BCS-120-L-S-TE | SamTec |  |  | $0.00 | AGM1264 | Cabinet
1 |  | CON | Socket for micro SD card | Molex | 473340001 | Digikey | WM3288CT-ND | $4.02 | $4.02 | MicroSD Slot | Valvano
0 |  | CON | USB Mini-B socket, board mount, through hole | Molex | 54819-0519 | Digikey | WM17115-ND | $0.65 | $0.00 | USB_Mini-B | Cabinet
0 |  | CON | Logic Analyzer connector |  |  | AllElectronics |  | $0.75 | $0.00 | LogicAnalyzer | Cabinet
0 |  | CON | JTAG 2 by 10 male header |  |  | AllElectronics | DHS-40 | $0.75 | $0.00 | JTAG | Cabinet
0 |  | CON | 10 pin 2mm socket for Xbee (need two) | SamTec | SQT-110-01-F-S | SamTec |  |  | $0.00 | XbeeModule | not free
0 |  | CON | DB9 serial connector, female, board mount |  |  | Jameco | 15771 | $0.65 | $0.00 | SerialDB9 | Cabinet
0 |  | CPU | LM3S811 48 pin LQFP | TI | LM3S811-IQN50-C2 | Digikey | 296-24918-ND | $6.88 | $0.00 | LM3S811 | Bard or Valvano or free sample
0 |  | CPU | LM3S1968 100 pin LQFP | TI | LM3S1968-IQC50-A2 | Digikey | 726-1113-ND | $11.50 | $0.00 | LM3S1968 | free sample
0 |  | CPU | LM3S8962 100 pin LQFP | TI | LM3S8962-IQC50-A2 | Digikey | 726-1126-ND | $14.19 | $0.00 | LM3S8962 | free sample
0 |  | CPU | MSP430F2012 PDIP | TI | MSP430F2012IN | Digikey | 296-19730-5-ND | $2.40 | $0.00 | MSP430F2012 | free sample
0 |  | CPU | MSP430T2012 module | TI | MSP430T2012 | TI |  | $3.33 | $0.00 | MSP430T2012 | not free
0 |  | CRYS | 6 MHz crystal,50ppm,HC49/US, CL=18pF | TXC CORP | 9B-6.000MAAJ-B | Digikey | 887-1005-ND | $0.46 | $0.00 | XTAL | Cabinet
0 |  | DIODE | 1N914 diode | Fairchild | 1N914 | Digikey | 1N914B-ND | $0.05 | $0.00 | 1N914 | Cabinet
0 |  | IC | ACCELER DUAL-AX 2.0G 8PLCC | Analog Devices | ADXL202JQC | Quest Components | ADXL202JQC | $7.50 | $0.00 | ADXL202 | Valvano
0 |  | IC | LM2937 3.3 V regulator TO220, 500mA | National | LM2937ET-3.3/NOPB | Digikey | LM2937ET-3.3-ND | $1.17 | $0.00 | LM2937-3.3 | Cabinet
0 |  | IC | LM2937-5.0 5V 500mA TO-220 regulator | National |  |  |  | $0.19 | $0.00 | LM7805CT | Do not use
0 |  | IC | LP2950 3.3V regulator, 100 mA TO-92 | On Semiconductor | LP2950ACZ-3.3G | Mouser | 863-LP2950ACZ-3.3G | $0.49 | $0.00 | LM317L | Cabinet
0 |  | IC | 78M05 500mA 5V TO-220 regulator | National | LM78M05 | Jameco | 192233 | $0.19 | $0.00 | LM7805CT | Cabinet
0 |  | IC | OPA4350 quad op amp | TI | OPA4350 | TI |  |  | $0.00 | OPA4350 | free sample
0 |  | IC | MC34119, AUDIO LOW PWR 8-PDIP | Freescale | MC34119 | Jameco | 316865 | $1.95 | $0.00 | MC34119 | Cabinet
0 |  | IC | TLV5616 12-bit DAC | TI | TLV5616 | TI | TLV5616CP |  | $0.00 | TLV5616 | Cabinet
0 |  | IC | MAX539 12-bit DAC | Maxim-IC | MAX539 | Maxim | MAX539ACPA |  | $0.00 | Max539 | Bard or Valvano or free sample
0 |  | IC | MAX1247 12-bit ADC | Maxim-IC | MAX1247 | Maxim | MAX1247ACPE+ |  | $0.00 | Max1247 | Bard or Valvano or free sample |  |  | 1 KD
0 |  | IC | INA122P instrumentation amp | TI | INA122P | TI | INA122P |  | $0.00 | INA122 | Bard or Valvano or free sample |  |  | 2 HD
0 |  | IC | OPA2350 dual op amp | TI | OPA2350PA | TI | OPA2350PA |  | $0.00 | OPA2350 | Bard or Valvano or free sample |  |  | 3 AD
0 |  | IC | TLC2274 quad op amp | TI | TLC2274ACN | TI | TLC2274ACN | $1.17 | $0.00 | TLC2274 | Bard or Valvano or free sample |  |  | 4 JD
0 |  | IC | LM4041CILPR shunt diode reference | TI | LM4041CILPR | TI | LM4041CILPR | $0.90 | $0.00 | LM4041 | Bard or Valvano or free sample |  |  | 5 CD
0 |  | IC | AD8032 dual op amp | Analog Devices | AD8032ANZ | Analog Devices | AD8032ANZ | $4.47 | $0.00 | AD8032 | free sample |  |  | 6 BD
0 |  | IC | L293 Motor H bridge | TI | L293NE | Digikey | 296-9519-5-ND | $3.50 | $0.00 | L293 | not free |  |  | 7 MD
0 |  | IC | 74HC595 |  |  | Jameco | 46105 | $0.40 | $0.00 |  | Cabinet
0 |  | IC | 74HC165 |  |  | Jameco | 45495 | $0.30 | $0.00 |  | Cabinet
0 |  | IC | RS232 driver | STMicroelectronics | ST232CN | Jameco | 2001171 | $0.58 | $0.00 | ST232 | not free |  |  | 8 ED
0 |  | JACK | DC Power MALE 2.1mm |  |  | Jameco | 101179 | $0.55 | $0.00 | PowerJack | Cabinet |  |  | 9 FD
0 |  | JACK | Stereo Jack, or audio jack |  |  | AllElectronics | MJW-12 | $0.09 | $0.00 | HeadphoneJack | Cabinet |  | 87YY3212A | 0 ND
0 |  | KEY | 3 by 4 common bus (D), keypad | Grayhill | 87YY3212A-506 | BGMicro | SWT1109 | $2.99 | $0.00 | 87YY3212A | Box | http://docs.bgmicro.com/pdf/swt1109.pdf |  | * LD
0 |  | LCD | 24 by 2 with back light |  |  | BGMicro | LCD1034 | $3.04 | $0.00 | LCD1034 | Box | got lots of these
0 |  | LCD | 16 by 2 with back light | Out of stock |  | BGMicro | LCD1031 | $5.95 | $0.00 | HD44780_16pin | not free | only 4 left |  | # GD
0 |  | LCD | 16 by 1 LCD | Out of stock |  | BGMicro | LCD100 | $5.00 | $0.00 | HD44780 | can borrow from 2nd floor, must return
0 |  | LCD | 64 by 128 graphics LCD |  |  | Sparkfun | LCD-00710 | $19.95 | $0.00 | LCD00710 | not free | http://www.sparkfun.com/products/710 | http://users.ece.utexas.edu/~valvano/arm/AGM1264_1968.zip
0 |  | LED | Green 2mA 5mm diffused | Avago Technologies | HLMP-4740 | Digikey | 516-1327-ND | $0.29 | $0.00 | LEDT1.75 | Cabinet
0 |  | LED | Red 1.6V 1mA 5mm diffused | Avago Technologies | HLMP-D150 | Digikey | 516-1323-ND | $0.29 | $0.00 | LEDT1.75 | Cabinet
0 |  | LED | Yellow 2mA 5mm diffused | Avago Technologies | HLMP-4719 | Digikey | 516-1326-ND | $0.29 | $0.00 | LEDT1.75 | Cabinet
0 |  | LED | Orange 10mA 5mm diffused | Avago Technologies | HLMP-D401 | Digikey | 516-1330-ND | $0.29 | $0.00 | LEDT1.75 | Cabinet
0 |  | LED | Blue 10mA 5mm diffused |  |  |  |  | $0.99 | $0.00 | LEDT1.75 | Cabinet | warning, the blue LEDs are very bright
0 |  | PCB | PCB plus shipping | Advanced Circuits |  | Advanced Circuits |  | $53.00 | $0.00 |  | http://www.4pcb.com/
0 |  | POT | 20K LINEAR SLIDE POT |  |  | AllElectronics | SP-20K | $0.33 | $0.00 | SmallPot | Valvano
0 |  | POT | 10 K one-turn potentiometer |  |  | BGMicro | RES1420 | $0.15 | $0.00 | SquarePot | Cabinet
0 |  | POT | 20 K one-turn potentiometer |  |  | BGMicro | RES1421 | $0.15 | $0.00 | SquarePot | Cabinet
2 |  | RES | Carbon 1/6W, 5%, 120 |  |  |  |  | $0.02 | $0.05
0 |  | RES | Carbon 1/6W, 5%, 220 | Yageo | CFR-12JB-220R | Digikey | 220EBK-ND | $0.02 | $0.00 | 0.125Wresistor | Cabinet
0 |  | RES | Carbon 1/6W, 5%, 270 | Yageo | CFR-12JB-270R | Digikey | 270EBK-ND | $0.02 | $0.00 | 0.125Wresistor | Cabinet
0 |  | RES | Carbon 1/6W, 5%, 470 | Yageo | CFR-12JB-470R | Digikey | 470EBK-ND | $0.02 | $0.00 | 0.125Wresistor | Cabinet
0 |  | RES | Carbon 1/6W, 5%, 680 | Yageo | CFR-12JB-680R | Digikey | 680EBK-ND | $0.02 | $0.00 | 0.125Wresistor | Cabinet
0 |  | RES | Carbon 1/6W, 5%, 820 | Yageo | CFR-12JB-820R | Digikey | 820EBK-ND | $0.02 | $0.00 | 0.125Wresistor | Cabinet
2 |  | RES | Carbon 1/6W, 5%, 1K | Yageo | CFR-12JB-1K0 | Digikey | 1.0KEBK-ND | $0.02 | $0.05 | 0.125Wresistor | Cabinet
0 |  | RES | Carbon 1/6W, 5%, 1.2K | Yageo | CFR-12JB-1K2 | Digikey | 1.2KEBK-ND | $0.02 | $0.00 | 0.125Wresistor | Cabinet
0 |  | RES | Carbon 1/6W, 5%, 1.5K | Yageo | CFR-12JB-1K5 | Digikey | 1.5KEBK-ND | $0.02 | $0.00 | 0.125Wresistor | Cabinet
0 |  | RES | Carbon 1/6W, 5%, 2.0K | Yageo | CFR-12JB-2K0 | Digikey | 2.0KEBK-ND | $0.02 | $0.00 | 0.125Wresistor | Cabinet
0 |  | RES | Carbon 1/6W, 5%, 2.2K | Yageo | CFR-12JB-2K2 | Digikey | 2.2KEBK-ND | $0.02 | $0.00 | 0.125Wresistor | Cabinet
0 |  | RES | Carbon 1/6W, 5%, 2.7K | Yageo | CFR-12JB-2K7 | Digikey | 2.7KEBK-ND | $0.02 | $0.00 | 0.125Wresistor | Cabinet
0 |  | RES | Carbon 1/6W, 5%, 3.3K | Yageo | CFR-12JB-3K3 | Digikey | 3.3KEBK-ND | $0.02 | $0.00 | 0.125Wresistor | Cabinet
0 |  | RES | Carbon 1/6W, 5%, 3.9K | Yageo | CFR-12JB-3K9 | Digikey | 3.9KEBK-ND | $0.02 | $0.00 | 0.125Wresistor | Cabinet
0 |  | RES | Carbon 1/6W, 5%, 4.7K | Yageo | CFR-12JB-4K7 | Digikey | 4.7KEBK-ND | $0.02 | $0.00 | 0.125Wresistor | Cabinet
0 |  | RES | Carbon 1/6W, 5%, 5.6K | Yageo | CFR-12JB-5K6 | Digikey | 5.6KEBK-ND | $0.02 | $0.00 | 0.125Wresistor | Cabinet
0 |  | RES | Carbon 1/6W, 5%, 6.8K | Yageo | CFR-12JB-6K8 | Digikey | 6.8KEBK-ND | $0.02 | $0.00 | 0.125Wresistor | Cabinet
0 |  | RES | Carbon 1/6W, 5%, 8.2K | Yageo | CFR-12JB-8K2 | Digikey | 8.2KEBK-ND | $0.02 | $0.00 | 0.125Wresistor | Cabinet
2 |  | RES | Carbon 1/6W, 5%, 10K | Yageo | CFR-12JB-10K | Digikey | 10KEBK-ND | $0.02 | $0.05 | 0.125Wresistor | Cabinet
0 |  | RES | Carbon 1/6W, 5%, 15K | Yageo | CFR-12JB-15K | Digikey | 15KEBK-ND | $0.02 | $0.00 | 0.125Wresistor | Cabinet | http://www.kemet.com/kemet/web/homepage/kechome.nsf/vapubfiles/F3101_GoldMax.pdf/$file/F3101_GoldMax.pdf
0 |  | RES | Carbon 1/6W, 5%, 20K | Yageo | CFR-12JB-20K | Digikey | 20KEBK-ND | $0.02 | $0.00 | 0.125Wresistor | Cabinet
0 |  | RES | Carbon 1/6W, 5%, 22K | Yageo | CFR-12JB-22K | Digikey | 22KEBK-ND | $0.02 | $0.00 | 0.125Wresistor | Cabinet
8 |  | RES | Carbon 1/6W, 5%, 27K | Yageo | CFR-12JB-27K | Digikey | 27KEBK-ND | $0.02 | $0.19 | 0.125Wresistor | Cabinet
0 |  | RES | Carbon 1/6W, 5%, 33K | Yageo | CFR-12JB-33K | Digikey | 33KEBK-ND | $0.02 | $0.00 | 0.125Wresistor | Cabinet
0 |  | RES | Carbon 1/6W, 5%, 47K | Yageo | CFR-12JB-47K | Digikey | 47KEBK-ND | $0.02 | $0.00 | 0.125Wresistor | Cabinet
0 |  | RES | Carbon 1/6W, 5%, 68K | Yageo | CFR-12JB-68K | Digikey | 68KEBK-ND | $0.02 | $0.00 | 0.125Wresistor | Cabinet
0 |  | RES | Carbon 1/6W, 5%, 82K | Yageo | CFR-12JB-82K | Digikey | 82KEBK-ND | $0.02 | $0.00 | 0.125Wresistor | Cabinet
0 |  | RES | Carbon 1/6W, 5%, 100K | Yageo | CFR-12JB-100K | Digikey | 100KEBK-ND | $0.02 | $0.00 | 0.125Wresistor | Cabinet
0 |  | RES | Carbon 1/6W, 5%, 120K | Yageo | CFR-12JB-120K | Digikey | 120KEBK-ND | $0.02 | $0.00 | 0.125Wresistor | Cabinet
0 |  | RES | Carbon 1/6W, 5%, 150K | Yageo | CFR-12JB-150K | Digikey | 150KEBK-ND | $0.02 | $0.00 | 0.125Wresistor | Cabinet
0 |  | RES | Carbon 1/6W, 5%, 200K | Yageo | CFR-12JB-200K | Digikey | 200KEBK-ND | $0.02 | $0.00 | 0.125Wresistor | Cabinet
0 |  | RES | Carbon 1/6W, 5%, 240K | Yageo | CFR-12JB-240K | Digikey | 240KEBK-ND | $0.02 | $0.00 | 0.125Wresistor | Cabinet
0 |  | RES | Carbon 1/6W, 5%, 330K | Yageo | CFR-12JB-330K | Digikey | 330KEBK-ND | $0.02 | $0.00 | 0.125Wresistor | Cabinet
0 |  | RES | Carbon 1/6W, 5%, 270K | Yageo | CFR-12JB-270K | Digikey | 270KEBK-ND | $0.02 | $0.00 | 0.125Wresistor | Cabinet
0 |  | RES | Carbon 1/6W, 5%, 470K | Yageo | CFR-12JB-470K | Digikey | 470KEBK-ND | $0.02 | $0.00 | 0.125Wresistor | Cabinet
0 |  | RES | Carbon 1/6W, 5%, 1M | Yageo | CFR-12JB-1M0 | Digikey | 1.0MEBK-ND | $0.02 | $0.00 | 0.125Wresistor | Cabinet
0 |  | RES | Carbon 1/6W, 5%, 10M | Yageo | CFR-12JB-10M | Digikey | 10MEBK-ND | $0.02 | $0.00 | 0.125Wresistor | Cabinet
0 |  | SW | B3F tactile push button switch | Omron Electronics | B3F-1052 | Digikey | SW405-ND | $0.17 | $0.00 | B3F-1050 | Cabinet
0 |  | SW | Black Off board momentary push buttom |  |  | AllElectronics | MPB-5 | $0.35 | $0.00 | OffBoardSwitch | Cabinet
0 |  | SW | Red Off board momentary push buttom |  |  | AllElectronics | MPB-1 | $0.35 | $0.00 | OffBoardSwitch | Cabinet
0 |  | SW | On/off power switch |  |  | BGMicro | SWT1010 | $0.85 | $0.00 | OffBoardPowerSwitch | Cabinet
0 |  | TRAN | PN2222 NPN transistor | Fairchild Semiconductor | PN2222 | Digikey | PN2222BU-ND | $0.13 | $0.00 | 2N2222 | Cabinet
0 |  | TRAN | TIP120 Darlington NPN, TO220 | Fairchild | TIP120 | Digikey | TIP120-ND | $0.68 | $0.00 | TIP120 | Valvano
0 |  | TRAN | TIP125 Darlington PNP, TO220 | Fairchild | TIP125 | Digikey | TIP125TU-ND | $0.67 | $0.00 | TIP125 | Valvano
0 |  | TRAN | IRF540 MOSFET N-channel, TO220 |  | IRF540 | Digikey | IRF540NPBF-ND | $1.95 | $0.00 | IRF540 | Valvano

Sheet: SurfaceMountParts
Quantity | REF DES | Type | Description | Manufacturer | Mfg. P/N | Distributor | P/N | Unit cost | Cost | PCB Artist | Where to get it?
0 |  | CAP | 0805 0.22 uF X7R ceramic |  |  |  |  | $0.14 | $0.00 | Ceramic0805 | Little box of surface mount parts
0 |  | CAP | 0805 220 pF C0G ceramic |  |  |  |  | $0.35 | $0.00 | Ceramic0805 | Little box of surface mount parts
0 |  | RES | 0805 1.1k 1% |  |  |  |  | $0.04 | $0.00 | 0.1WresistorSM805 | Little box of surface mount parts
0 |  | RES | 0805 10k 1% |  |  |  |  | $0.04 | $0.00 | 0.1WresistorSM805 | Little box of surface mount parts
0 |  | RES | 0805 20k 1% |  |  |  |  | $0.04 | $0.00 | 0.1WresistorSM805 | Little box of surface mount parts
0 |  | RES | 0805 25.5k 1% |  |  |  |  | $0.04 | $0.00 | 0.1WresistorSM805 | Little box of surface mount parts
0 |  | RES | 0805 100k 1% |  |  |  |  | $0.04 | $0.00 | 0.1WresistorSM805 | Little box of surface mount parts
