nykh/ee445m-robot-team13/Labs/Lab7D/motor.c

// motor.c
// Runs on TM4C123
// Use PWM0/PB6 to generate pulse-width modulated outputs.
// Daniel Valvano
// September 3, 2013

/* This example accompanies the book
   "Embedded Systems: Real Time Interfacing to ARM Cortex M Microcontrollers",
   ISBN: 978-1463590154, Jonathan Valvano, copyright (c) 2013
  Program 6.7, section 6.3.2

 Copyright 2013 by Jonathan W. Valvano, valvano@mail.utexas.edu
    You may use, edit, run or distribute this file
    as long as the above copyright notice remains
 THIS SOFTWARE IS PROVIDED "AS IS".  NO WARRANTIES, WHETHER EXPRESS, IMPLIED
 OR STATUTORY, INCLUDING, BUT NOT LIMITED TO, IMPLIED WARRANTIES OF
 MERCHANTABILITY AND FITNESS FOR A PARTICULAR PURPOSE APPLY TO THIS SOFTWARE.
 VALVANO SHALL NOT, IN ANY CIRCUMSTANCES, BE LIABLE FOR SPECIAL, INCIDENTAL,
 OR CONSEQUENTIAL DAMAGES, FOR ANY REASON WHATSOEVER.
 For more information about my classes, my research, and my books, see
 http://users.ece.utexas.edu/~valvano/
 */
 
#include "motor.h"
#include <tm4c123gh6pm.h>

#define PB7      (*((volatile unsigned long *)0x40005200))
#define PB5      (*((volatile unsigned long *)0x40005080))

#define PERIOD       25000

// period is 16-bit number of PWM clock cycles in one period (3<=period)
// duty is number of PWM clock cycles output is high  (2<=duty<=period-1)
// PWM clock rate = processor clock rate/SYSCTL_RCC_PWMDIV
//                = BusClock/2 
//                = 50 MHz/2 = 25 MHz (in this example)
void Motor_Init(unsigned short duty){   volatile unsigned long delay;
  
  /*************** New Style ******************/
	SYSCTL_RCGCPWM_R |= SYSCTL_RCGCPWM_R0;   // 1) activate PWM0
    SYSCTL_RCGCGPIO_R |= SYSCTL_RCGCGPIO_R1; // 2) activate port B
    delay = SYSCTL_RCGCGPIO_R;               // allow time to finish activating
  /********************************************/
  
	GPIO_PORTB_AFSEL_R |= 0x50;           // enable alt funct on PB4,6
	GPIO_PORTB_AFSEL_R &= ~0xA0;		  // disable alt funct on PB5,7
	GPIO_PORTB_DIR_R	|= 0xA0;		  // set PB5,7 output
	GPIO_PORTB_PCTL_R = (GPIO_PORTB_PCTL_R &~0x0F0F0000) | 0x04040000;   // configure PB4,6 as PWM0
	GPIO_PORTB_AMSEL_R &= ~0xF0;          // disable analog functionality on PB4,5,6,7
	GPIO_PORTB_DEN_R |= 0xF0;             // enable digital I/O on PB4,5,6,7
	
	PB5 = PB7 = MOTOR_CW;
	
	SYSCTL_RCC_R |= SYSCTL_RCC_USEPWMDIV; // 3) use PWM divider
	SYSCTL_RCC_R &= ~SYSCTL_RCC_PWMDIV_M; //    clear PWM divider field
	SYSCTL_RCC_R |= SYSCTL_RCC_PWMDIV_2;  //    configure for /2 divider
	
	PWM0_0_CTL_R = PWM0_1_CTL_R = 0;      // 4) re-loading mode
	PWM0_0_GENA_R = (PWM_0_GENA_ACTCMPAD_ONE|PWM_0_GENA_ACTLOAD_ZERO);
	PWM0_1_GENA_R = (PWM_1_GENA_ACTCMPAD_ONE|PWM_1_GENA_ACTLOAD_ZERO);
	
	PWM0_0_LOAD_R = PWM0_1_LOAD_R = PERIOD - 1;           // 15) cycles needed to count down to 0
	PWM0_0_CMPA_R = PWM0_1_CMPA_R = duty - 1;             // 6) count value when output rises
	
	PWM0_0_CTL_R |= PWM_0_CTL_ENABLE;     // 7) start PWM0
	PWM0_1_CTL_R |= PWM_1_CTL_ENABLE;  //!!
	
	PWM0_ENABLE_R |= (PWM_ENABLE_PWM0EN | PWM_ENABLE_PWM2EN);   // enable PWM0
}

// change duty cycle
// duty is number of PWM clock cycles output is high  (2<=duty<=period-1)
//R
// Motor 0 uses
// PB7 as direction pin
// PB6 as PWM
void Motor_0_MotionUpdate(unsigned long duty, unsigned char direction){
	long value ;
	if (duty<2) duty = 2;
	if (duty>PERIOD-2) duty = PERIOD -2;
	
	PB7 = (direction != 0)<<7;          // PB7 controls the direction of one wheel
	value = (direction)?(PERIOD - duty):(duty);           // 6) count value when output rises
	PWM0_0_CMPA_R = value;
}
//L
// Motor 1 uses
// PB5 as direction pin
// PB4 as PWM
void Motor_1_MotionUpdate(unsigned long duty, unsigned char direction){
	long value;
	if (duty<2) duty = 2;
	if (duty>PERIOD-2) duty = PERIOD -2;
	
	PB5 = (direction != 0)<<5;          // PB5 controls the direction of one wheel
	value = (direction)?(PERIOD - duty):(duty);           // 6) count value when output rises
	PWM0_1_CMPA_R = value;
}

// Input: [-(PERIOD-2), -2] U [2, PERIOD-2]
void Motor_MotionUpdate(long duty0, long duty1){	
	char dir0, dir1;
	if (!(dir0 = (duty0>0))) {
		duty0 = -duty0;
	}
	duty0 += MOTOR_DIFF;
	
	if (!(dir1 = (duty1>0))) {
		duty1 = -duty1;
	}
	
	PB7 = dir0 << 7;
	PB5 = dir1 << 5;
	
	if (duty0<2) duty0 = 2;
	if (duty0>PERIOD-2) duty0 = PERIOD -2;
	if (duty1<2) duty1 = 2;
	if (duty1>PERIOD-2) duty1 = PERIOD -2;

	PWM0_0_CMPA_R = (dir0)? (PERIOD - duty0):(duty0);
	PWM0_1_CMPA_R = (dir1)? (PERIOD - duty1):(duty1);
	
}

void Motor_Stop(void) {
	PB7 = PB5 = 0;
	PWM0_0_CMPA_R = PWM0_1_CMPA_R = 2;
}
	
	
