nykh/ee445m-robot-team13/Labs/Lab7D/semaphore.c

#include "semaphore.h"

Sema4Type	Sema4UART;
Sema4Type Sema4CharAvailable;

Sema4Type Sema4fifo;
Sema4Type Sema4MailboxEmpty;
Sema4Type Sema4MailboxFull;

Sema4Type Sema4FFTReady;
Sema4Type	Sema4DataAvailable;

Sema4Type Sema4CAN;
