nykh/ee445m-robot-team13/module/sqrt.c

// Newton's method
// s is an integer
// sqrt(s) is an integer
unsigned long sqrt(unsigned long s){
unsigned long t;         // t*t will become s
int n;                   // loop counter to make sure it stops running
  t = s/10+1;            // initial guess 
  for(n = 16; n; --n){   // guaranteed to finish
    t = ((t*t+s)/t)/2;  
  }
  return t; 
}
