nykh/ee445m-robot-team13/(commit log)

2014-04-01 PWM: use bit-specified addressing.
2014-04-01 Copy of PWM in module folder
2014-04-01 Rename to motor.c/h
2014-04-01 Rename to motor
2014-04-02 Changes in lab 6: Updated gpio_debug, updated main for a simple test of CAN, deleted pwm.c from the project
2014-04-02 updated can0.c to use semaphores correctly, they also receive any message and restore the IDs Added lab6_main1: Consumer thread that receives CAN messages and prints on the LCD Added lab6_main2: empty
    [can0.c, can0.h]
2014-04-02 IR sensor: remaining bug: ADC sequencers
    [FIFO_sema4.h, adc.c, adc.h]
2014-04-03 Added ir_sensor.c: compiling state modified adc.c lab6_main for receiver added FIFO_sema4.h
2014-04-03 Updated send function in can0.c added prototypes in ir_sensor.h updated lab6_main to have different mains for transmitter receiver
2014-04-03 make into new styles, the bug persists
    [OS.c, can0.c, can0.h]
2014-04-03 Fixed bugs in OS, main, and CAN0_Open
    [OS.c, can0.c]
2014-04-05 Report folder
    [IR_sensor_coefficient.xlsx]
2014-04-05 can0.c and lab6 main working for both ir and ultra sensor
2014-04-14 PWM works, by Chen
2014-04-16 Moved PWM_4C123
2014-04-16 update PWM
2014-04-16 Added PWM
2014-04-17 Motor: fixed, myADC: simplify, OS: small changes
    [OS.c, OS.h, Ping.c, UART2.c, interpreter.c, motor.c, motor.h, myadc.c]
2014-04-17 myadc is a simplified version of ADC that samples four data. IR_sensor gets rid of FIFOs and filters
2014-04-20 Updated PWM Module
2014-04-20 Robot: finish code for IR and Ping sensors. Now they are all char and can pack into one CAN frame
    [IR_Sensor_Data.xlsx]
2014-04-23 Motor, IR_sensor, main
2014-04-23 ir_sensor.c: macro to apply filter
2014-04-24 Lab 7C updated, added Steering right and left states
2014-04-25 Changed sensor; added hysteresis
2014-04-28 Ping: calculate error on the fly Main: D term
    [Ping.c, lab7_main.c]
2014-04-29 Calibrated until nearly being done for 7C. Added the 3-minute limit
2014-05-05 Call graph data flow graph
